SkyRizzAI/SkyRizz-E32/PCB/assets/skyrizz-e32.png

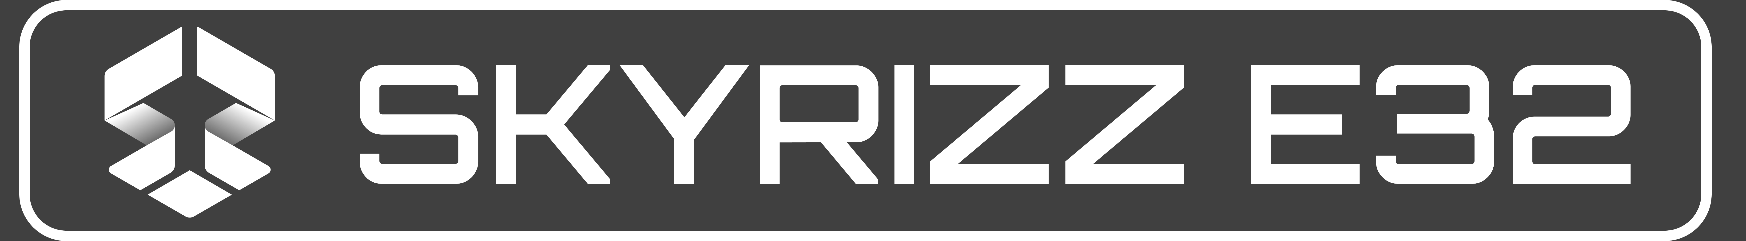
PCB/assets/skyrizz-e32.png
