SkyRizzAI/SkyRizz-E32/PCB/pcb-prototype-alpha-back.jpeg

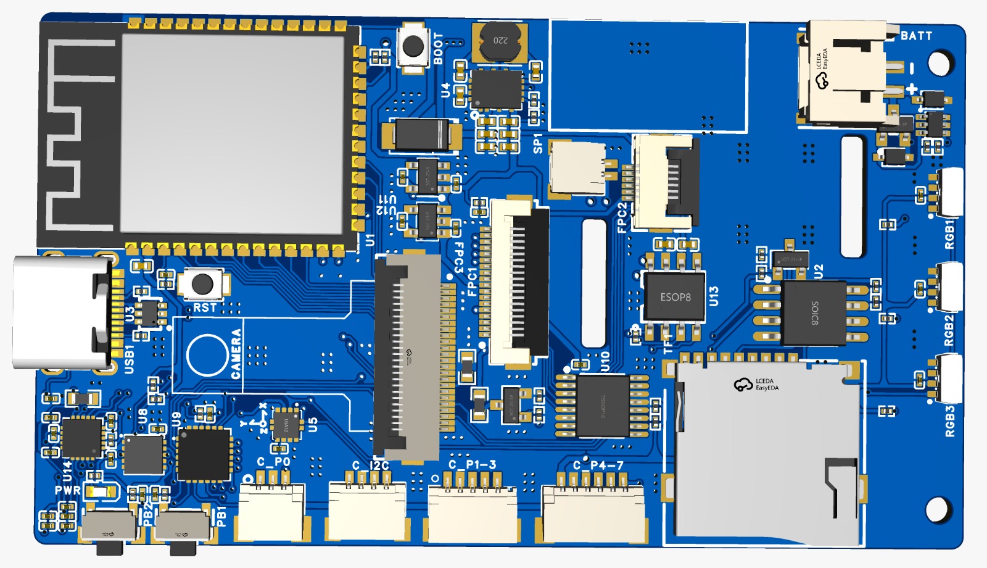
PCB/pcb-prototype-alpha-back.jpeg
