SkyRizzAI/SkyRizz-E32/PCB/pcb-prototype-alpha-front.jpeg

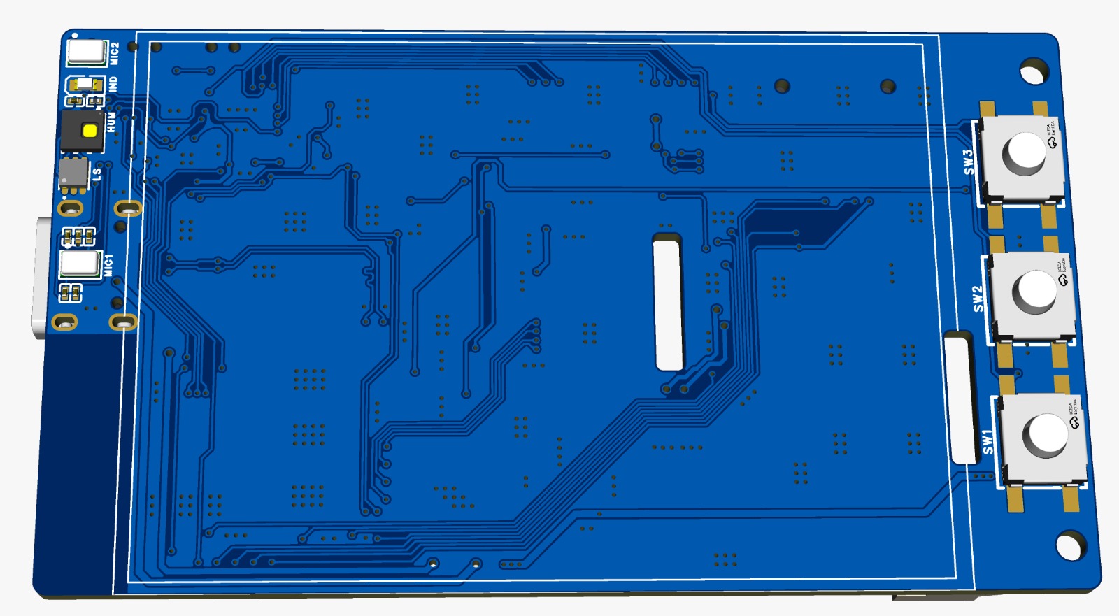
PCB/pcb-prototype-alpha-front.jpeg
