SkyRizzAI/SkyRizz-E32/PCB/v1.1/BOM-SKYRIZZ-E32-v1.1.xlsx

No. | Quantity | Comment | Designator | Footprint | Value | Manufacturer Part | Manufacturer | Supplier Part | Supplier
1 | 1 | MX1.25mm-2P-WT | BAT1 | CONN-SMD_MX1.25-2P-WT |  | MX1.25mm-2P-WT | LXWCONN(连兴旺电子) | C53055348 | LCSC
2 | 2 | B3U-1000P | BOOT,RST | KEY-SMD_B3U-1000PM |  | B3U-1000P | OMRON(欧姆龙) | C231329 | LCSC
3 | 3 | 10uF | C1,C66,C68 | C0402 | 10uF | CL05A106MQ5NUNC | SAMSUNG(三星) | C15525 | LCSC
4 | 2 | 22uF | C2,C45 | C0402 | 22uF | CL05A226MQ5QUNC | SAMSUNG(三星) | C105226 | LCSC
5 | 9 | 1uF | C3,C26,C27,C28,C37,C38,C39,C42,C43 | C0201 | 1uF | CL03A105MQ3CSNH | SAMSUNG(三星) | C53067 | LCSC
6 | 2 | 15pF | C6,C40 | C0201 | 15pF | GRM0335C1H150JA01D | muRata(村田) | C85891 | LCSC
7 | 17 | 100nF | C18,C19,C20,C21,C22,C23,C24,C25,C29,C30,C36,C41,C62,C63,C64,C65,C67 | C0201 | 100nF | CL03A104KP3NNNC | SAMSUNG(三星) | C49062 | LCSC
8 | 4 | 2.2uF | C46,C47,C48,C50 | C0201 | 2.2uF | GRM033R60J225ME47D | muRata(村田) | C76933 | LCSC
9 | 4 | 10uF | C51,C52,C59,C60 | C0402 | 10uF | GRM155R61A106ME44D | muRata(村田) | C77000 | LCSC
10 | 1 | 1uF | C54 | C0402 | 1uF | CL05A105KA5NQNC | SAMSUNG(三星) | C52923 | LCSC
11 | 4 | 100nF | C56,C57,C58,C61 | C0402 | 100nF | CL05B104KO5NNNC | SAMSUNG(三星) | C1525 | LCSC
12 | 2 | SM04B-SRSS-TB(LF)(SN) | C_I2C,C_P4-5 | CONN-SMD_4P-P1.00_SM04B-SRSS-TB-LF-SN |  | SM04B-SRSS-TB(LF)(SN) | JST | C160404 | LCSC
13 | 1 | SM03B-SRSS-TB(LF)(SN) | C_P0 | CONN-SMD_SM03B-SRSS-TB-LF-SN-P |  | SM03B-SRSS-TB(LF)(SN) | JST | C160403 | LCSC
14 | 1 | SM05B-SRSS-TB(LF)(SN) | C_P1-3 | CONN-SMD_SM05B-SRSS-TB-LF-SN |  | SM05B-SRSS-TB(LF)(SN) | JST | C136657 | LCSC
15 | 1 | SS34 | D2 | SMA_L4.3-W2.6-LS5.2-RD |  | SS34 | MDD(辰达半导体) | C8678 | LCSC
16 | 2 | PTVSUC3D5VB | D5,D6 | SOD-323_L1.8-W1.3-LS2.5-BI |  | PTVSUC3D5VB | Prisemi(芯导) | C918847 | LCSC
17 | 1 | FPC-0.5FX-18PWBH15 | FPC1 | FPC-SMD_18P-P0.50_XUNPU_FPC-0.5FX-18PWBH15 |  | FPC-0.5FX-18PWBH15 | XUNPU(讯普) | C3446030 | LCSC
18 | 1 | FPC06-T1T1-2021-A | FPC2 | FPC-SMD_FPC06-T1T1-2021-A |  | FPC06-T1T1-2021-A | SHETIME(高钺达) | C52740858 | LCSC
19 | 1 | FPC-0.5FX-24PH20 | FPC3 | FPC-SMD_24P-P0.50_YUANDI_FPC-0.5FX-24PH20 |  | FPC-0.5FX-24PH20 | Yuandi(元迪) | C19077718 | LCSC
20 | 1 | SHT20-TR-1.5KS | HUM | DFN-6_L3.0-W3.0-P0.95-TR-EP |  | SHT20-TR-1.5KS | Sensirion(瑞士盛思锐) | C53865 | LCSC
21 | 1 | KT-0603YG | IND | LED0603-RD |  | KT-0603YG | KENTO | C2289 | LCSC
22 | 1 | 2.2uH | L1 | IND-SMD_L3.5-W3.0 | 2.2uH | SM3521-2R2MT | SXN(顺翔诺) | C9890 | LCSC
23 | 2 | KT-0603R | LED1,PWR | LED0603-RD |  | KT-0603R | KENTO | C2286 | LCSC
24 | 1 | LTR-303ALS-01 | LS | TDFN-6_L2.0-W2.0-P0.65-BL |  | LTR-303ALS-01 | LITEON(光宝) | C364577 | LCSC
25 | 2 | MSM381ACP003 | MIC1,MIC2 | MIC-SMD_4P-L2.8-W1.9-TR_MSM381ACP003 |  | MSM381ACP003 | MEMS(敏芯微) | C51928212 | LCSC
26 | 2 | TS24CA | PB1,PB2 | SW-SMD_2P-TS24CA |  | TS24CA | SHOU HAN(首韩) | C393942 | LCSC
27 | 1 | AO3401A | Q2 | SOT-23-3_L2.9-W1.3-P1.90-LS2.4-BR_SMV2022-004LF |  | AO3401A | AOS | C15127 | LCSC
28 | 1 | BCM857BS | Q3 | SOT-363_L2.1-W1.3-P0.65-LS2.3-BL |  | BCM857BS | FUXINSEMI(富芯森美) | C20426291 | LCSC
29 | 2 | MMBT3904 | Q4,Q5 | SOT-23-3_L2.9-W1.3-P1.90-LS2.4-BR |  | MMBT3904 | DOWO(东沃) | C22374713 | LCSC
30 | 24 | 10kΩ | R1,R4,R6,R7,R12,R13,R14,R18,R20,R24,R27,R28,R29,R31,R33,R34,R35,R36,R37,R38,R39,R40,R43,R44 | R0201 | 10kΩ | 0201WMF1002TEE | UNI-ROYAL(厚声) | C473048 | LCSC
31 | 1 | 1kΩ | R2 | R0201 | 1kΩ | 0201WMF1001TEE | UNI-ROYAL(厚声) | C270365 | LCSC
32 | 2 | 5.1kΩ | R3,R5 | R0201 | 5.1kΩ | 0201WMF5101TEE | UNI-ROYAL(厚声) | C270344 | LCSC
33 | 3 | 2kΩ | R15,R19,R41 | R0201 | 2kΩ | 0201WMF2001TEE | UNI-ROYAL(厚声) | C270358 | LCSC
34 | 1 | 330Ω | R16 | R0201 | 330Ω | 0201WMJ0331TEE | UNI-ROYAL(厚声) | C473445 | LCSC
35 | 1 | 4.7Ω | R17 | R0603 | 4.7Ω | 0603WAF470KT5E | UNI-ROYAL(厚声) | C23164 | LCSC
36 | 1 | 3.3kΩ | R21 | R0201 | 3.3kΩ | 0201WMF3301TEE | UNI-ROYAL(厚声) | C270350 | LCSC
37 | 2 | 0Ω | R22,R32 | R0603 | 0Ω | 0603WAF0000T5E | UNI-ROYAL(厚声) | C21189 | LCSC
38 | 1 | 27kΩ | R23 | R0201 | 27kΩ | 0201WMF2702TEE | UNI-ROYAL(厚声) | C270351 | LCSC
39 | 2 | 100kΩ | R25,R26 | R0201 | 100kΩ | 0201WMF1003TEE | UNI-ROYAL(厚声) | C270364 | LCSC
40 | 2 | XL-0807RGBC-2812B | RGB1,RGB2 | LED-SMD_4P-L2.0-W1.8_XL-0807RGBC-WS2812B |  | XL-0807RGBC-2812B | XINGLIGHT(成兴光) | C3646929 | LCSC
41 | 3 | SKPMAPE010 | SW1,SW2,SW3 | KEY-SMD_2P-L6.0-W6.0-P6.00 |  | SKPMAPE010 | ALPSALPINE(阿尔卑斯阿尔派) | C110292 | LCSC
42 | 1 | TF-CARD H1.8 | TF1 | TF-SMD_TF-CARD-H1.8 |  | TF-CARD H1.8 | SHOU HAN(首韩) | C7529389 | LCSC
43 | 1 | ESP32-S3-WROOM-1-N16R8 | U1 | WIRELM-SMD_ESP32-S3-WROOM-1 |  | ESP32-S3-WROOM-1-N16R8 | ESPRESSIF(乐鑫) | C2913202 | LCSC
44 | 1 | GT30L24A3W | U2 | SOIC-8_L5.3-W5.3-P1.27-LS8.0-BL |  | GT30L24A3W | GENITOP(高通) | C124688 | LCSC
45 | 1 | PUSB2X4Y | U3 | SOT-363-6_L2.0-W1.3-P0.65-LS2.1-BL |  | PUSB2X4Y | TECH PUBLIC(台舟) | C2905617 | LCSC
46 | 1 | JW3651QFNE#TRPBF | U4 | QFN-15_L4.0-W3.0_JW3655E |  | JW3651QFNE#TRPBF | Joulwatt(杰华特) | C5444670 | LCSC
47 | 1 | SC7A20HTR | U5 | LGA-12_L2.0-W2.0-P0.50-TL |  | SC7A20HTR | SILAN(士兰微) | C19274408 | LCSC
48 | 1 | XL9535QF24 | U9 | QFN-24_L4.0-W4.0-P0.50-BL-EP2.6 |  | XL9535QF24 | XINLUDA(信路达) | C5444301 | LCSC
49 | 1 | TSC2007IPWR | U10 | TSSOP-16_L5.0-W4.4-P0.65-LS6.4-BL |  | TSC2007IPWR | TI(德州仪器) | C38398 | LCSC
50 | 1 | BL8555-28PRA | U11 | SOT-23-5_L3.0-W1.7-P0.95-LS2.8-BL |  | BL8555-28PRA | BL(上海贝岭) | C2834972 | LCSC
51 | 1 | AP7343Q-18W5-7 | U12 | SOT-23-5_L3.0-W1.7-P0.95-LS2.8-BR |  | AP7343Q-18W5-7 | DIODES(美台) | C3746471 | LCSC
52 | 1 | NS4168 | U13 | ESOP-8_L4.9-W3.9-P1.27-LS6.0-BL-EP |  | NS4168 | Nsiway(纳芯威) | C910588 | LCSC
53 | 1 | ES7243E | U14 | QFN-20_L3.0-W3.0-P0.40-BL-EP1.7 |  | ES7243E | Everest-semi(顺芯) | C2929446 | LCSC
54 | 1 | MCP73831T-2ACI/OT | U17 | SOT-23-5_L3.0-W1.7-P0.95-LS2.8-BL |  | MCP73831T-2ACI/OT | MICROCHIP(美国微芯) | C424093 | LCSC
55 | 1 | SE050C2HQ1/Z01SDZ | U18 | WQFN-20_L3.0-W3.0-P0.40-BL-EP1.7 |  | SE050C2HQ1/Z01SDZ | NXP(恩智浦) | C2659345 | LCSC
56 | 1 | USB-TYPE-C-018 | USB1 | USB-C_SMD-TYPE-C-31-M-12 |  | USB-TYPE-C-018 | DEALON(德艺隆) | C2927038 | LCSC
