SkyRizzAI/SkyRizz-E32/PCB/v1.1/SKYRIZZ-E32-Schematic-v1.1.pdf

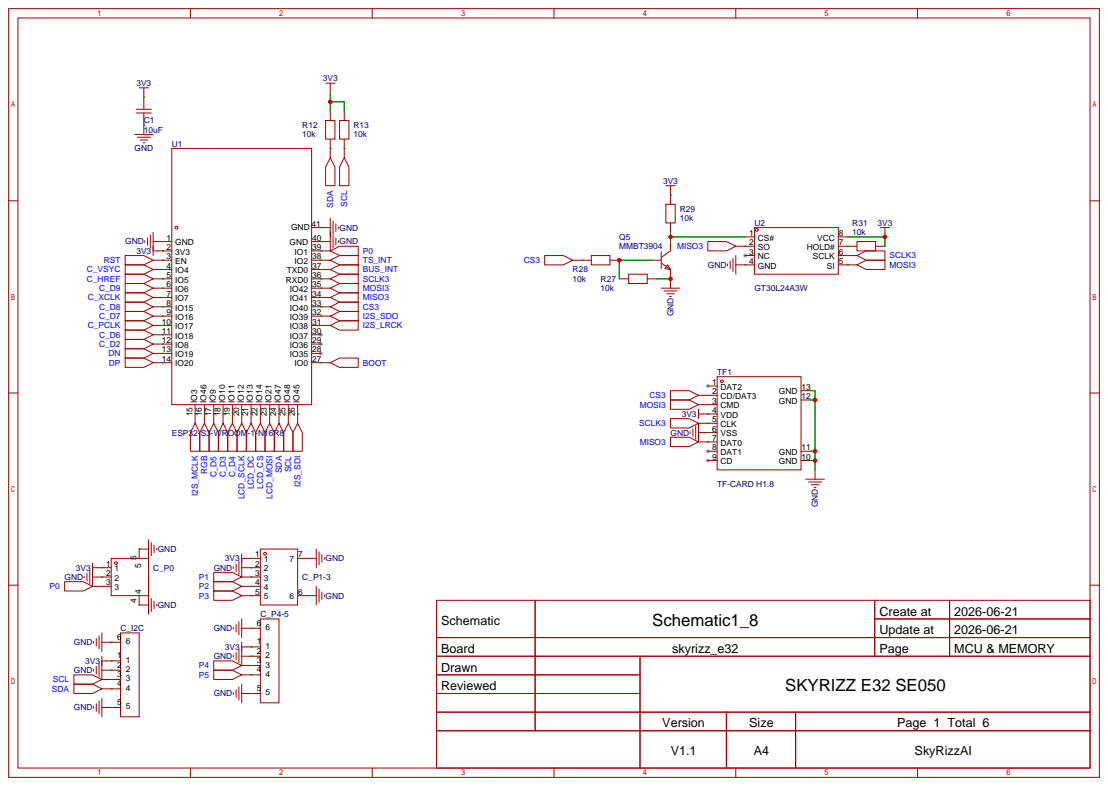
[picture p5: page 1]

Schematic | Schematic1_8 | Create at | 2026-06-21

Update at | 2026-06-21

Board | skyrizz_e32 | Page | MCU & MEMORY

Version | Size | Page 1 Total 6
V1.1 | A4 | SkyRizzAI

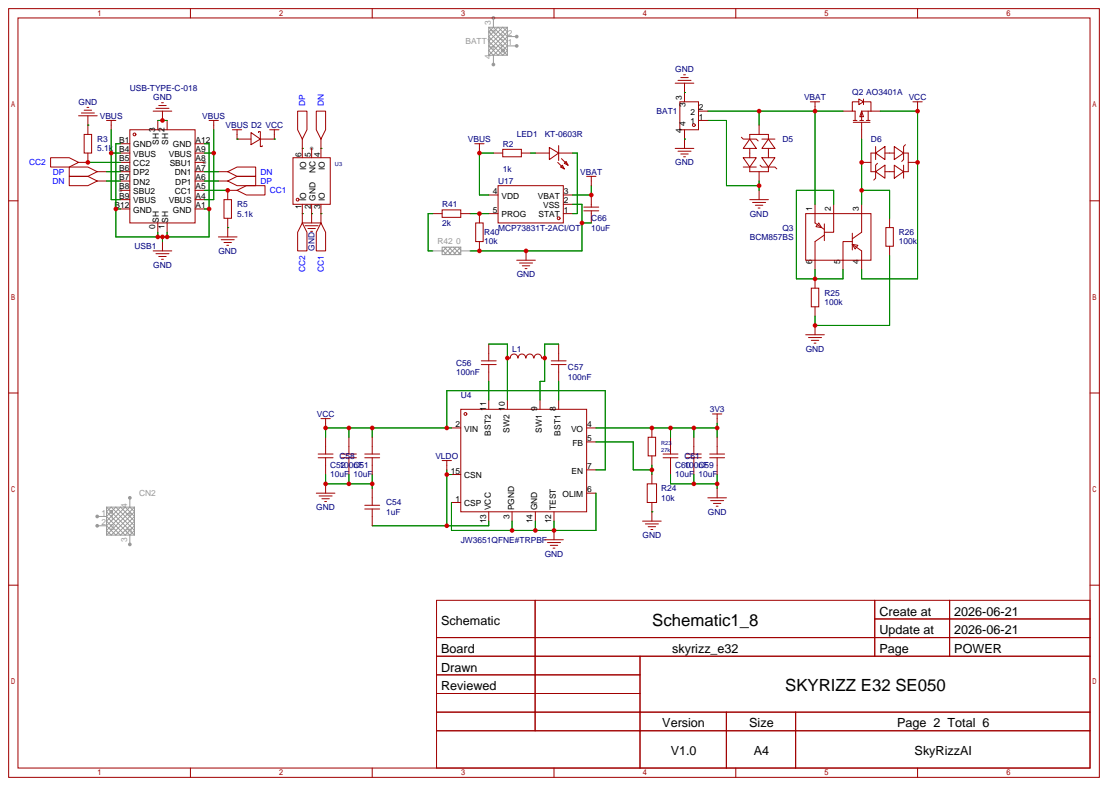
[picture p6: page 2]

Schematic | Schematic1_8 | Create at | 2026-06-21

Update at | 2026-06-21

Board | skyrizz_e32 | Page | POWER
Drawn | | SKYRIZZ E32 SE050
Reviewed

Version | Size | Page 2 Total 6
V1.0 | A4 | SkyRizzAI

# SE_RST EP ²¹

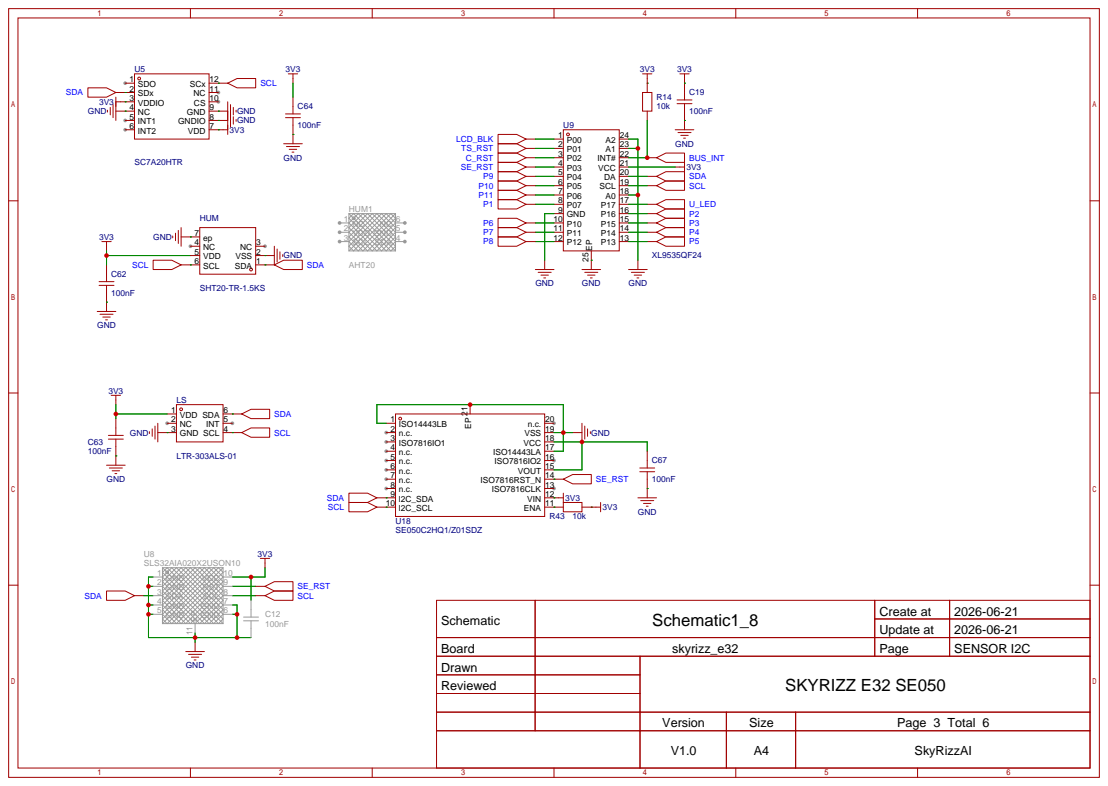
[picture p7: page 3]

Schematic | Schematic1_8 | Create at | 2026-06-21

Update at | 2026-06-21

Board | skyrizz_e32 | Page | SENSOR I2C
Drawn | | SKYRIZZ E32 SE050
Reviewed

# ONLY RESISTIVE TOUCH ONLY CAPACITIVE TOUCH

10 10 11 11 12 12 13 13 14 14 15 15 16 16 17 17 18 18 19 19 20 20 21 21 22 22 23 23 24 24

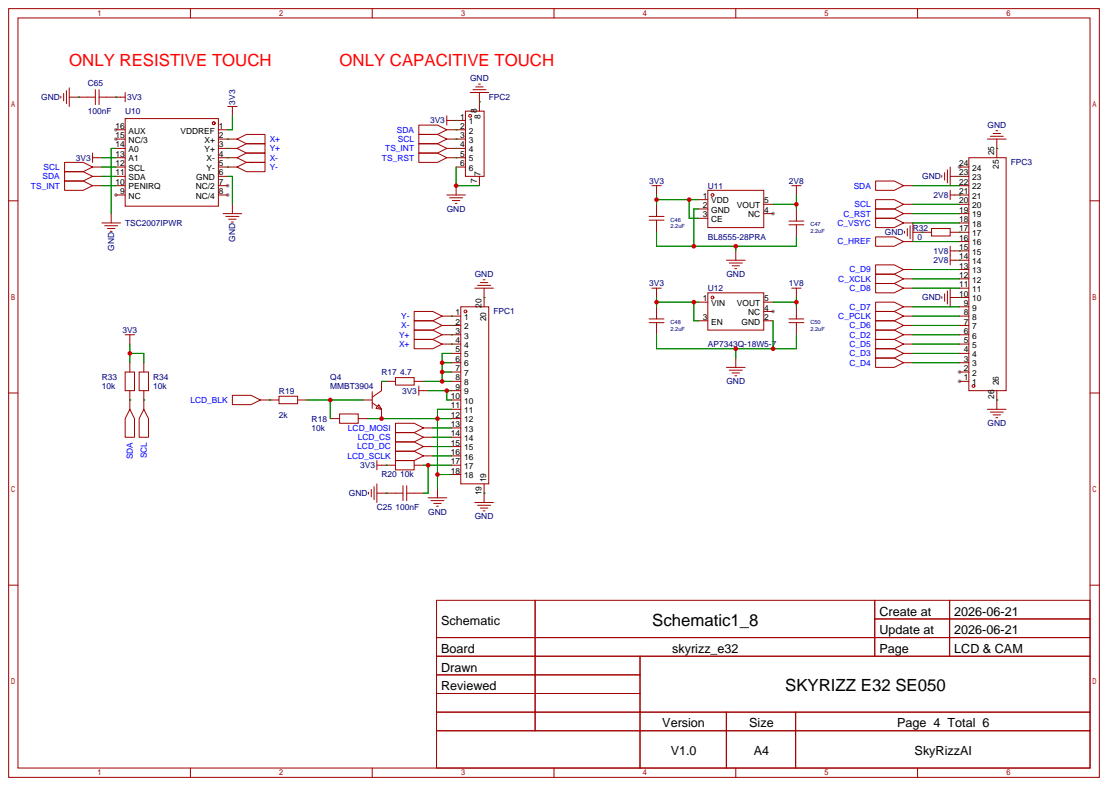
[picture p8: page 4]

Schematic | Schematic1_8 | Create at | 2026-06-21

Update at | 2026-06-21

Board | skyrizz_e32 | Page | LCD & CAM
Drawn | | SKYRIZZ E32 SE050
Reviewed

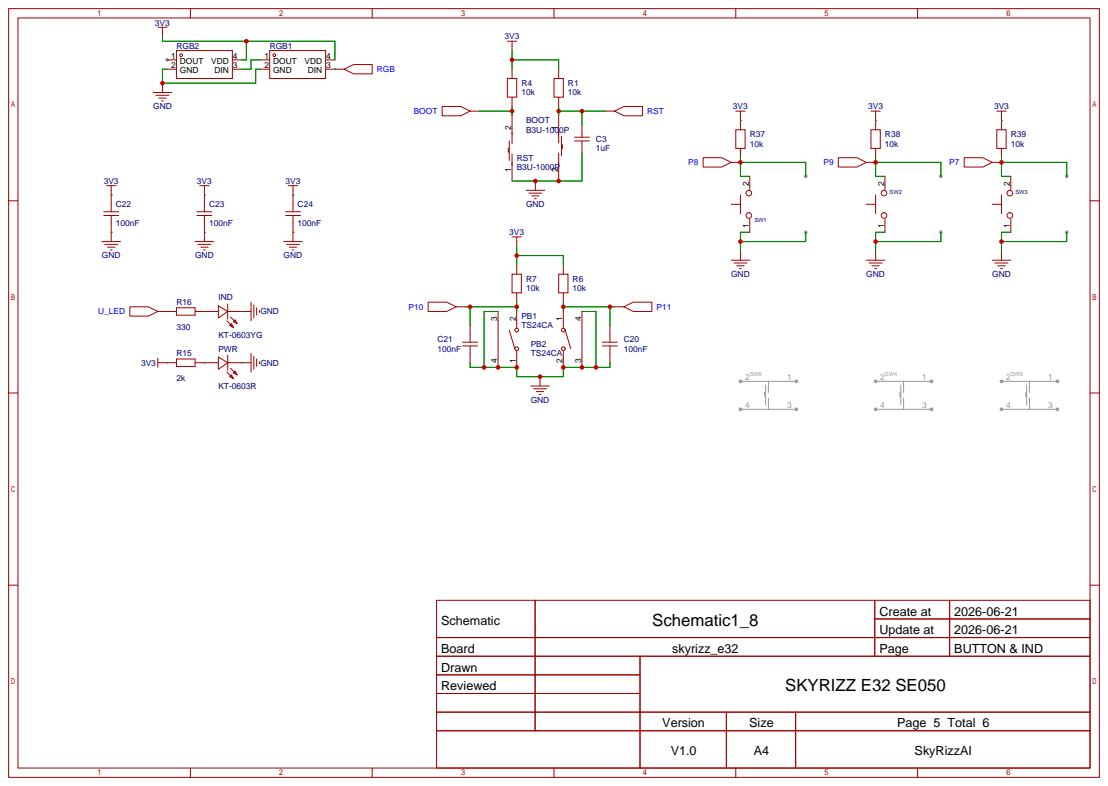
[picture p9: page 5]

Schematic | Schematic1_8 | Create at | 2026-06-21

Update at | 2026-06-21

Board | skyrizz_e32 | Page | BUTTON & IND
Drawn | | SKYRIZZ E32 SE050
Reviewed

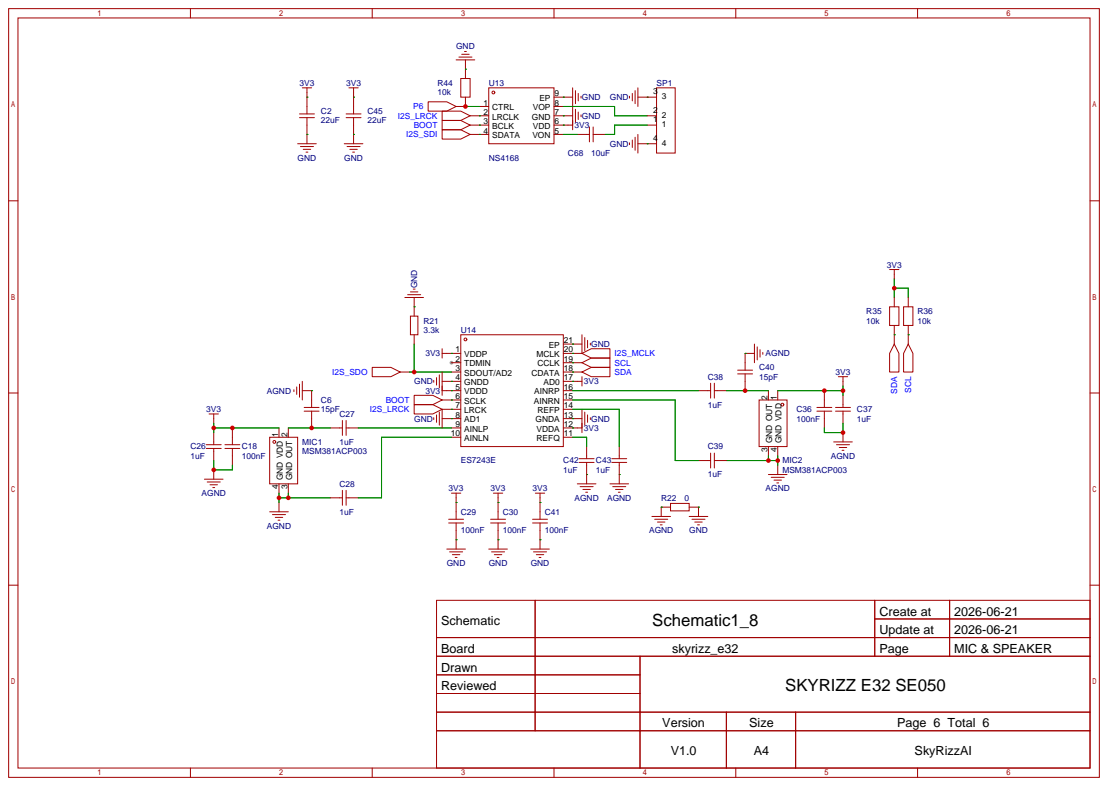
[picture p10: page 6]

Schematic | Schematic1_8 | Create at | 2026-06-21

Update at | 2026-06-21

Board | skyrizz_e32 | Page | MIC & SPEAKER
Drawn | | SKYRIZZ E32 SE050
Reviewed
