SkyRizzAI/SkyRizz-E32/PCB/v1.0/PCB-design-alpha.pdf

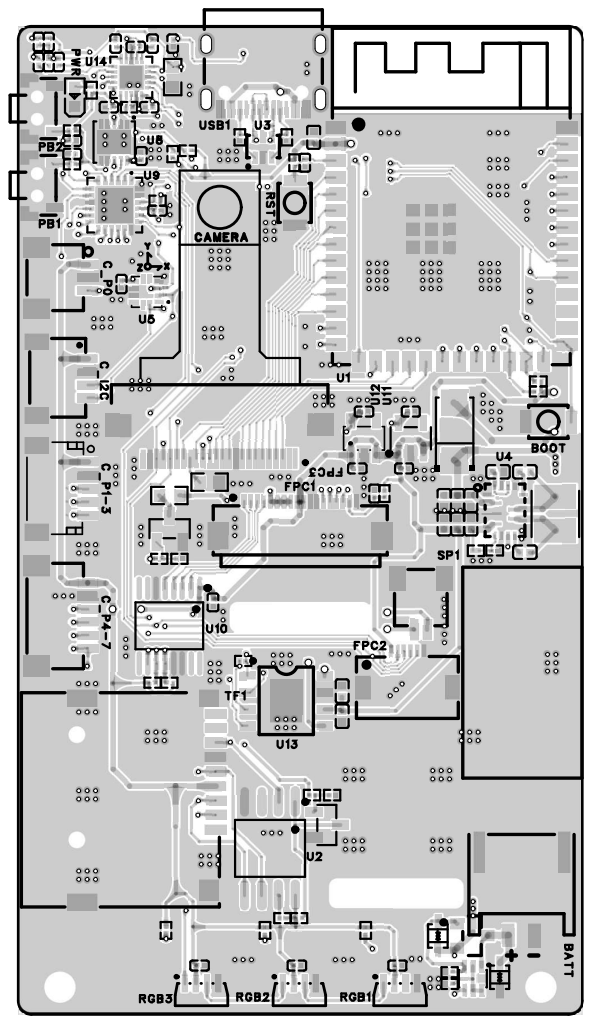
[picture p17: page 1]

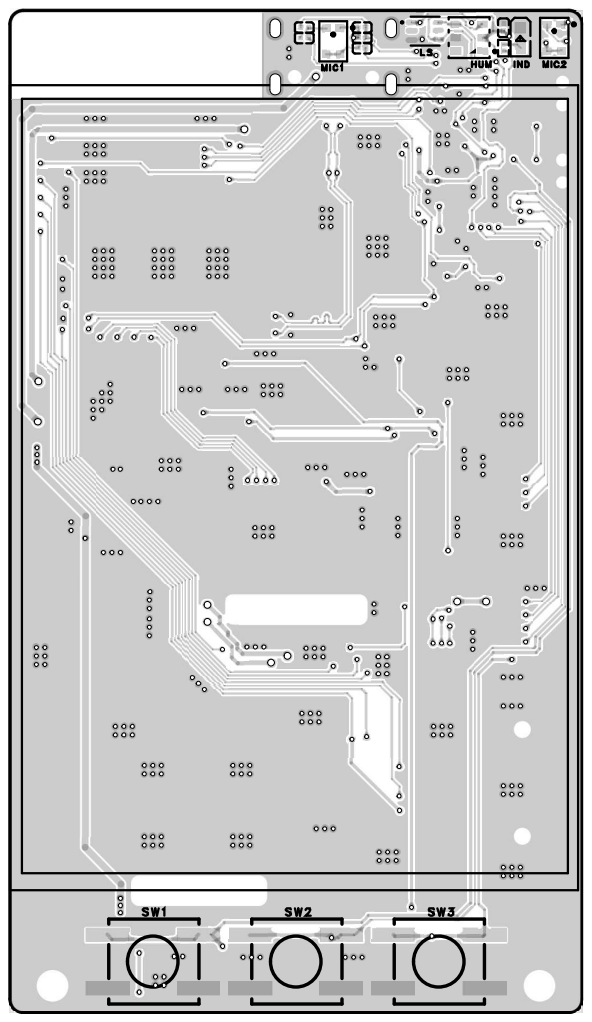
[picture p18: page 2]
