SkyRizzAI/SkyRizz-E32/(list of files, drawings)

Other design files:
PCB/v1.0/skyrizz_e32_se050.epro
PCB/v1.1/skyrizz_e32._se050-v1.1.epro
