SkyRizzAI/SkyRizz-E32/examples/display_testing_menu/src/camera.rs

//! GC2145 camera support for the SkyRizz E32.
//!
//! Pin map (FPC3 / DVP, shared SCCB on the main I2C bus):
//!   XCLK = GPIO7  (CAM_CLK from LCD_CAM peripheral master clock)
//!   VSYNC = GPIO4
//!   HREF  = GPIO5
//!   PCLK  = GPIO17
//!   D2 -> CAM_DATA0 = GPIO8
//!   D3 -> CAM_DATA1 = GPIO10
//!   D4 -> CAM_DATA2 = GPIO11
//!   D5 -> CAM_DATA3 = GPIO9
//!   D6 -> CAM_DATA4 = GPIO18
//!   D7 -> CAM_DATA5 = GPIO16
//!   D8 -> CAM_DATA6 = GPIO15
//!   D9 -> CAM_DATA7 = GPIO6
//! Reset (C_RST) is gated by the XL9535 expander on P02 (active LOW).
//!
//! GC2145 quirks:
//! - SCCB only ACKs once XCLK is running.
//! - Register 0xFE is the "page select" (0x00 = sensor, 0x01 = AEC,
//!   0x02 = ISP, 0xF0 = system). Always set the page before touching
//!   anything else.
//! - Chip ID is 0x21 / 0x45 at registers 0xF0 / 0xF1 of the system page.
//!
//! Output: RGB565 320x240 (default crop window in the public init table).

use embedded_hal::delay::DelayNs;
use esp_hal::{
    delay::Delay,
    i2c::master::I2c,
    Blocking,
};

/// GC2145 SCCB I2C address (7-bit).
pub const GC2145_ADDR: u8 = 0x3C;

/// Width / height of the RGB565 frame produced by GC2145 with the default
/// settings used here.
pub const FRAME_W: u16 = 320;
pub const FRAME_H: u16 = 240;
pub const FRAME_BYTES: usize = (FRAME_W as usize) * (FRAME_H as usize) * 2;

/// Sentinel for table delays: write `(REG_DLY, ms)`.
const REG_DLY: u8 = 0xFD;
/// End-of-table sentinel (must not collide with any real reg we write).
const REG_END_KEY: u8 = 0xEE;
const REG_END_VAL: u8 = 0xEE;

/// Result of a sensor probe.
#[derive(Debug, Clone, Copy, PartialEq, Eq)]
pub enum Probe {
    /// chip_id_high (reg 0xF0) and chip_id_low (0xF1) in the system page.
    Found { id_h: u8, id_l: u8 },
    NotFound,
    BusError,
}

/// Probe GC2145 on the SCCB. Expects XCLK to already be running.
pub fn probe(i2c: &mut I2c<'_, Blocking>) -> Probe {
    // Address-only probe.
    let mut tmp = [0u8; 1];
    if i2c.read(GC2145_ADDR, &mut tmp).is_err() {
        return Probe::NotFound;
    }
    // Switch to system page and read chip id.
    if i2c.write(GC2145_ADDR, &[0xFE, 0xF0]).is_err() {
        return Probe::BusError;
    }
    let mut h = [0u8; 1];
    let mut l = [0u8; 1];
    if i2c.write_read(GC2145_ADDR, &[0xF0], &mut h).is_err() {
        return Probe::BusError;
    }
    if i2c.write_read(GC2145_ADDR, &[0xF1], &mut l).is_err() {
        return Probe::BusError;
    }
    Probe::Found { id_h: h[0], id_l: l[0] }
}

/// Apply the default GC2145 init then switch the output to RGB565 320x240.
pub fn init_gc2145_rgb565(i2c: &mut I2c<'_, Blocking>) -> Result<(), ()> {
    let mut delay = Delay::new();
    apply_table(i2c, &mut delay, GC2145_DEFAULT_INIT)?;
    apply_table(i2c, &mut delay, GC2145_RGB565_OVERRIDE)?;
    Ok(())
}

fn apply_table(
    i2c: &mut I2c<'_, Blocking>,
    delay: &mut Delay,
    table: &[(u8, u8)],
) -> Result<(), ()> {
    for &(reg, val) in table {
        if reg == REG_END_KEY && val == REG_END_VAL {
            return Ok(());
        }
        if reg == REG_DLY {
            delay.delay_ms(val as u32);
            continue;
        }
        if i2c.write(GC2145_ADDR, &[reg, val]).is_err() {
            return Err(());
        }
    }
    Ok(())
}

// =====================================================================
// GC2145 default init table (sensor + ISP + AEC + AWB + gamma + LSC + CC).
// Source: espressif/esp32-camera sensors/private_include/gc2145_settings.h
// (gc2145_default_init_regs). The output crop at the end is 320x240.
// =====================================================================
#[rustfmt::skip]
const GC2145_DEFAULT_INIT: &[(u8, u8)] = &[
    // ----- system / soft reset -----
    (0xFE, 0xF0), (0xFE, 0xF0), (0xFE, 0xF0),
    (0xFC, 0x06),
    (0xF6, 0x00),
    (0xF7, 0x1D),
    (0xF8, 0x83),
    (0xFA, 0x00),
    (0xF9, 0xFE),
    (0xC2, 0x00),
    (0xF2, 0x0F),

    // ----- analog & cisctl (page 0) -----
    (0xFE, 0x00),
    (0x03, 0x04), (0x04, 0x62),
    (0x05, 0x01), (0x06, 0x3B),
    (0x09, 0x00), (0x0A, 0x00),
    (0x0B, 0x00), (0x0C, 0x00),
    (0x0D, 0x04), (0x0E, 0xC0),
    (0x0F, 0x06), (0x10, 0x52),
    (0x12, 0x2E),
    (0x17, 0x14), (0x18, 0x22),
    (0x19, 0x0F), (0x1A, 0x01),
    (0x1B, 0x4B), (0x1C, 0x07),
    (0x1D, 0x10), (0x1E, 0x88),
    (0x1F, 0x78), (0x20, 0x03),
    (0x21, 0x40), (0x22, 0xA0),
    (0x24, 0x1E), (0x25, 0x01),
    (0x26, 0x10), (0x2D, 0x60),
    (0x30, 0x01), (0x31, 0x90),
    (0x33, 0x06), (0x34, 0x01),

    // ----- ISP (still page 0) -----
    (0x80, 0xFF), (0x81, 0x24),
    (0x82, 0xFA), (0x83, 0x00),
    (0x84, 0x02),                 // output format = YUV422 (overridden later)
    (0x86, 0x03),
    (0x88, 0x03), (0x89, 0x03),
    (0x85, 0x30),
    (0x8A, 0x00), (0x8B, 0x00),
    (0xB0, 0x55), (0xC3, 0x00),
    (0xC4, 0x80), (0xC5, 0x90),
    (0xC6, 0x38), (0xC7, 0x40),
    (0xEC, 0x06), (0xED, 0x04),
    (0xEF, 0x90),
    (0xB6, 0x01),
    (0x90, 0x01),
    (0x91, 0x00), (0x92, 0x00),
    (0x93, 0x00), (0x94, 0x00),
    (0x95, 0x04), (0x96, 0xB0),
    (0x97, 0x06), (0x98, 0x40),

    // ----- BLK -----
    (0x18, 0x02),
    (0x40, 0x42), (0x41, 0x00),
    (0x43, 0x54),
    (0x5E, 0x00), (0x5F, 0x00),
    (0x60, 0x00), (0x61, 0x00),
    (0x62, 0x00), (0x63, 0x00),
    (0x64, 0x00), (0x65, 0x00),
    (0x66, 0x20), (0x67, 0x20),
    (0x68, 0x20), (0x69, 0x20),
    (0x76, 0x00),
    (0x6A, 0x00), (0x6B, 0x00),
    (0x6C, 0x3E), (0x6D, 0x3E),
    (0x6F, 0x3F),
    (0x70, 0x00), (0x71, 0x00),
    (0x72, 0xF0), (0x7E, 0x3C),
    (0x7F, 0x00),

    // ----- ISP page 2: ASDE -----
    (0xFE, 0x02),
    (0x48, 0x15), (0x49, 0x00),
    (0x4B, 0x0B),
    (0xFE, 0x00),

    // ----- AEC (page 1) -----
    (0xFE, 0x01),
    (0x01, 0x04), (0x02, 0xC0),
    (0x03, 0x04), (0x04, 0x90),
    (0x05, 0x30), (0x06, 0x90),
    (0x07, 0x20), (0x08, 0x70),
    (0x09, 0x00), (0x0A, 0xC2),
    (0x0B, 0x11), (0x0C, 0x10),
    (0x13, 0x40), (0x17, 0x00),
    (0x1C, 0x11), (0x1E, 0x61),
    (0x1F, 0x30), (0x20, 0x40),
    (0x22, 0x80), (0x23, 0x20),

    (0xFE, 0x02), (0x0F, 0x04),

    (0xFE, 0x01),
    (0x12, 0x35), (0x15, 0x50),
    (0x10, 0x31), (0x3E, 0x28),
    (0x3F, 0xE0), (0x40, 0x20),
    (0x41, 0x0F),

    (0xFE, 0x02), (0x0F, 0x05),

    // ----- INTPEE (page 2) -----
    (0x90, 0x6C), (0x91, 0x03),
    (0x92, 0xC8), (0x94, 0x66),
    (0x95, 0xB5), (0x97, 0x64),
    (0xA2, 0x11),
    (0xFE, 0x00),

    // ----- DNDD (page 2) -----
    (0xFE, 0x02),
    (0x80, 0xC1), (0x81, 0x08),
    (0x82, 0x08), (0x83, 0x08),
    (0x84, 0x0A), (0x86, 0xF0),
    (0x87, 0x50), (0x88, 0x15),
    (0x89, 0x50), (0x8A, 0x30),
    (0x8B, 0x10),

    // ----- ASDE -----
    (0xFE, 0x01),
    (0x21, 0x14),

    (0xFE, 0x02),
    (0xA3, 0x40), (0xA4, 0x20),
    (0xA5, 0x40), (0xA6, 0x80),
    (0xAB, 0x40),
    (0xAE, 0x0C),
    (0xB3, 0x34), (0xB4, 0x44),
    (0xB6, 0x38), (0xB7, 0x02),
    (0xB9, 0x30),
    (0x3C, 0x08), (0x3D, 0x30),
    (0x4B, 0x0D), (0x4C, 0x20),
    (0xFE, 0x00),

    // ----- gamma1 (page 2 / 0x10..0x25) -----
    (0xFE, 0x02),
    (0x10, 0x10), (0x11, 0x15),
    (0x12, 0x1A), (0x13, 0x1F),
    (0x14, 0x2C), (0x15, 0x39),
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
#[rustfmt::skip]
const GC2145_RGB565_OVERRIDE: &[(u8, u8)] = &[
    (0xFE, 0x00),
    (0x84, 0x06),                 // output format = RGB565
    (0x86, 0x02),                 // sync polarity: VSYNC active high
    (REG_END_KEY, REG_END_VAL),
];
