SkyRizzAI/SkyRizz-E32/(commit log)

2026-02-19 feat: initialize document for schematic and pcb
2026-02-28 feat: New Schematic v1.0 and BOM with some assets
    [BOM-SKYRIZZ-E32-v1.0.xlsx]
2026-03-15 feat: Pinout diagram and maping plus no_std board pin in embedded rust
2026-03-15 fix: missing components and new testing script
    [no_std_board_pins.rs, no_std_board_self_test.rs]
2026-03-21 feat: easyEDA source files, pnp, gerber and update readme plus license
    [PickAndPlace_E32-v1.0.xlsx, skyrizz_e32_se050.epro]
2026-05-03 feat: sample testing using rust no_std
2026-06-21 feat: v1.1 with fix on short ground and temperature sensor issue and fix jumper
    [BOM-SKYRIZZ-E32-v1.0.xlsx, BOM-SKYRIZZ-E32-v1.1.xlsx, PickAndPlace_E32-v1.0.xlsx, PickAndPlace_PCB1_8_2026-06-18.xlsx, skyrizz_e32._se050-v1.1.epro, skyrizz_e32_se050.epro]
